Libertine-FPE/Open-airway/Alternative control board.pdf

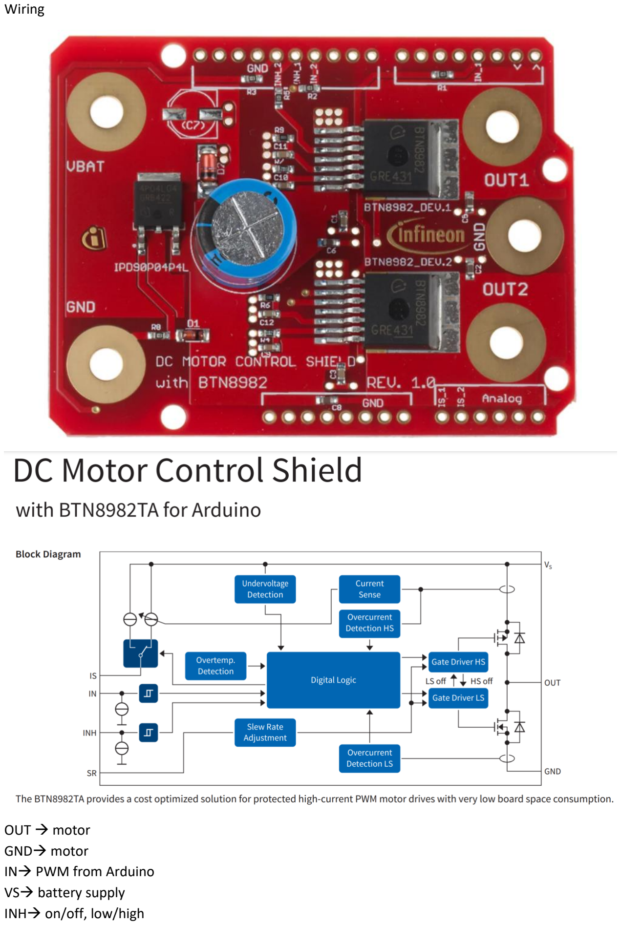
[picture p10: page 1]

Wiring

OUT → motor
GND→ motor
IN→ PWM from Arduino
VS→ battery supply
INH→ on/off, low/high

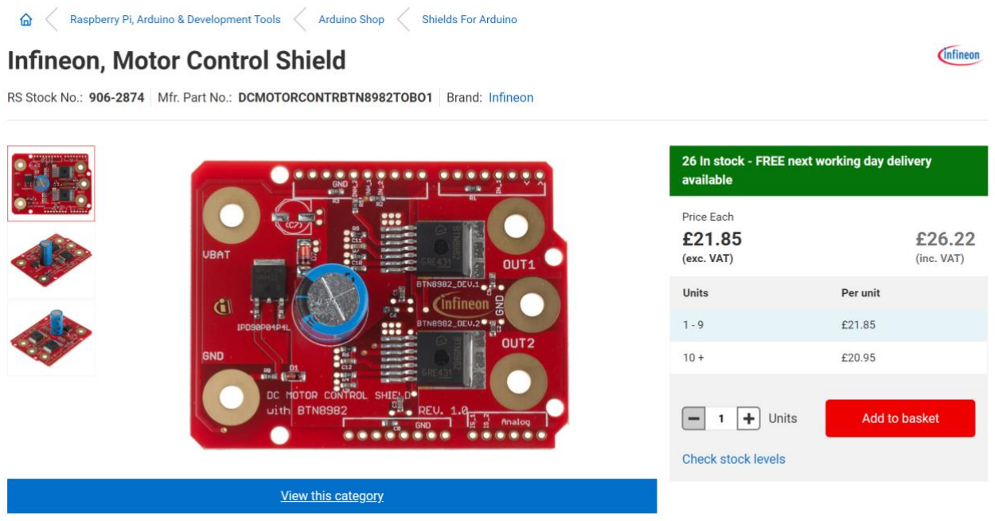
[picture p11: figure]

https://uk.rs-online.com/web/p/shields-for-arduino/9062874/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 (https://uk.rs-online.com/web/p/shields-for-arduino/9062874/?matchtype=&pla-341184811176&gclsrc=aw.ds)
