Libertine-FPE/Open-airway/BOM - Complete v2.xlsx

Open-airway.com Bag Valve Mask actuator |  |  |  |  |  |  | Version | 2 |  | Contact | Sam Cockerill
Bill of Materials |  |  |  |  |  |  | Date | 2020-04-16 |  | email | sam.cockerill@libertine.co.uk
Section | Short name | Component description | Vendor website | Vendor part number | Manufacturer | Mfr Part No | Quantity | Price per unit exc (£) | Min quantity | RoHS Compliant | Note
3D printed parts |  | BVA BASE LEFT v2 |  |  |  |  | 1 |  | 1 |  | PLA Filament
3D printed parts |  | BVA BASE RIGHT v2 |  |  |  |  | 1 |  | 1 |  | PLA Filament
3D printed parts |  | BVA BOTTOM STATOR SUPPORT v2 |  |  |  |  | 1 |  | 1 |  | PLA Filament
3D printed parts |  | BVA UPPER STATOR SUPPORT |  |  |  |  | 1 |  | 1 |  | PLA Filament
3D printed parts |  | BVA RISER v2 |  |  |  |  | 1 |  | 1 |  | PLA Filament
3D printed parts |  | BVA RISER SUPPORT |  |  |  |  | 1 |  | 1 |  | PLA Filament
3D printed parts |  | BVA MASK STRAP CLIP |  |  |  |  | 1 |  | 1 |  | PLA Filament
3D printed parts |  | BVA BAG PUSHER v2 |  |  |  |  | 2 |  | 2 |  | PLA Filament
3D printed parts |  | BVA CONTROL KNOB |  |  |  |  | 2 |  | 2 |  | PLA Filament
3D printed parts |  | BVA STATOR END CAP |  |  |  |  | 2 |  | 2 |  | ABS Filament
3D printed parts |  | BVA COIL BOBBIN |  |  |  |  | 2 |  | 2 |  | ABS Filament
3D printed parts |  | BVA END PLATE |  |  |  |  | 2 |  | 2 |  | ABS Filament
3D printed parts |  | BVA OUTER HOLDER |  |  |  |  | 2 |  | 2 |  | ABS Filament
3D printed parts |  | BVA ROD HOLDER |  |  |  |  | 2 |  | 2 |  | ABS Filament
Electrical machine |  | BVA BACK IRON |  |  |  |  | 2 |  | 2 |  | Manufacture to Drawing PDF
Electrical machine |  | BVA OUTER IRON |  |  |  |  | 2 |  | 2 |  | Manufacture to Drawing PDF
Electrical machine | Copper | 1.120mm Polyester C200 G2 D250 (~400turns/91m) | https://www.par.uk.com |  | P.A.R. Insulations & Wires Ltd |  | 2 | 6.15/kg | 20kg
Fixings | Threaded Insert | RS PRO, M6 Brass Threaded Insert diameter 8mm Depth 12.7mm | https://uk.rs-online.com/ | 278-578 | RS-PRO | 278-578 | 10 | 0.195 | 100
Fixings | Spring | RS PRO Steel Alloy Compression Spring, 80.5mm x 8.63mm, 0.17N/mm | https://uk.rs-online.com/ | 751-512 | RS-PRO | 751-512 | 5 | 0.71 | 5
Fixings | Bush | RS PRO Nylon Screw Insulator, M6, 8mm | https://uk.rs-online.com/ | 178-844 | RS-PRO | 178-844 | 2 | 0.08 | 50
Fixings | Studding | RS PRO Zinc Plated Steel Threaded Bar 0.242m | https://uk.rs-online.com/ | 530-321 | RS-PRO | 530-321 | 2 | 2.01 | 5
Fixings | M6x16 Screw | RS PRO M6 x 16mm Hex Socket Cap Screw Bright Zinc Plated Steel | https://uk.rs-online.com/ | 483-8326 | RS-PRO | 483-8326 | 4 | 0.144 | 100
Fixings | M6x30 Screw | RS PRO M6 x 30mm Hex Socket Cap Screw Bright Zinc Plated Steel | https://uk.rs-online.com/ | 483-8348 | RS-PRO | 483-8348 | 1 | 0.16 | 100
Fixings | 4mmx70 Screw | Pozidriv CSK Steel Wood Screw Yellow Passivated, Zinc Plated, 4mmx70mm | https://uk.rs-online.com/ | 145-6471 | UNIFIX VORTEX | ZZV60233CE | 5 | 0.031 | 200
Fixings | 3.5mmx30 Screw | Pozidriv CSK Wood Screw A2 3.5mm Thread 30mm Length | https://uk.rs-online.com/ | 144-3509 | RS-PRO | 144-3509 | 6 | 0.036 | 100
Fixings | No.6 Self Tap Screw | RS PRO BZP Steel Pan Head Self Tapping Screw, N°6 x 9.5mm Long | https://uk.rs-online.com/ | 546-5654 | RS-PRO | 546-5654 | 2 | 0.026 | 100
Fixings | M6 Washer | Bright Zinc Plated Steel Plain Washer, 1.5mm Thickness, M6 (Form C) | https://uk.rs-online.com/ | 122-4379 | RS-PRO | 122-4379 | 4 | 0.019 | 100
Fixings | Wago Connector | Wago 221 Terminal Block Connector, 2 Way/Pole, Spring Cage Terminals | https://uk.rs-online.com/ | 883-7544 | RS-PRO | 221-412 | 6 | 0.326 | 10
Fixings | P Clip | 9.5mm Black Polyamide P Clip | https://uk.rs-online.com/ | 474-543 | HellermannTyton | 211-60004 H5P-PA66HS-BK (100) | 2 | 0.072 | 100
Fixings | UNF Screw | 10-32 X 3/4 Inch UNF Cap Head Screws (ANSI B18.3) - A2 Stainless Steel | https://www.accu.co.uk | SSC-10-32-3/4-A2 | ACCU | SSC-10-32-3/4-A2 | 2 | 0.35 | 2
Electronics |  | Arduino Uno Rev3 MCU Development Board A000066 | https://uk.rs-online.com/ | 715-4081 | Arduino | A000066 | 1 | 16.44 | 1 | Yes
Electronics |  | MIKROE-512, 10 piece Breadboard Jumper Wire Kit | https://uk.rs-online.com/ | 791-6454 | MikroElektronika | MIKROE-512 | 1 | 2.41 | 1 | Yes
Electronics |  | MIKROE-511, 10 piece Breadboard Jumper Wire Kit | https://uk.rs-online.com/ | 791-6450 | MikroElektronika | MIKROE-511 | 1 | 2.41 | 1 | Yes
Electronics |  | RS PRO 10kΩ 0.25W Carbon Film Resistor ±5% | https://uk.rs-online.com/ | 707-7745 | RS PRO |  | 2 | 0.108 | 10 | Yes
Electronics |  | EA Elektro-Automatik Digital Bench Power Supply 320W, 1 Output 0 → 42V 20A | https://uk.rs-online.com/ | 756-8821 | EA Elektro-Automatik | EA-PS 2042-20B | 1 | 288.71 | 1 | Yes | Alternative cheap fixed supply 12V 20A PSU 161-8225 for £46.85
Electronics |  | VNH5019 Motor Driver Carrier 12A | https://www.pololu.com/product/1451 |  | VNH5019 | Pololu | 1 | 19.2 | 1 | Yes | Alternative 393-9377, or solid state relay with similar characteristics, 5V control, 20V@20A, with minimum of 500ms switch time
Electronics |  | CTS Linear Potentiometer with an 6.35 mm Dia. Shaft - 1kΩ, ±20%, 5W Power Rating, Linear, SMD | https://uk.rs-online.com/ | 179-0664 | CTS | 026TB32R102B1A1 | 2 | 2.58 | 1 | Yes
Electronics |  | Natural, White Round Tactile Switch, Single Pole Single Throw (SPST) 50 mA 2.5 (Dia.)mm PCB | https://uk.rs-online.com/ | 909-7993 | TE Connectivity | 1571634-2 | 4 | 0.133 | 10 | Yes
Electronics |  | Alpha Wire Black, 3.3 mm² Hook Up Wire EcoWire Series , 30m | https://uk.rs-online.com/ | 687-7639 | Alpha Wire | 6718 BK005 | 1 | 42.84 | 1 | Yes
Electronics |  | Alpha Wire Red, 3.3 mm² Hook Up Wire EcoWire Series , 30m | https://uk.rs-online.com/ | 687-7648 | Alpha Wire | 6718 RD005 | 1 | 42.84 | 1 | Yes
Electronics |  | 2.2 V Green LED 3mm Through Hole, Kingbright L-934GD | https://uk.rs-online.com/ | 228-5944 | Kingbright | L-934GD | 2 | 0.4 | 5 | Yes
Electronics |  | 2 V Red LED 3mm Through Hole, Kingbright L-934ID | https://uk.rs-online.com/ | 228-5916 | Kingbright | L-934ID | 2 | 0.4 | 5 | Yes
Electronics |  | Marquardt Single Pole Single Throw (SPST), On-None-Off Rocker Switch Panel Mount | https://uk.rs-online.com/ | 741-0902 | Marquardt | 1831.3313 | 1 | 2.33 | 1 | Yes
Electronics |  | RS PRO Single Pole Single Throw (SPST) Latching Push Button Switch, 4.95 (Dia.)mm, Panel Mount, 32/50/12 | https://uk.rs-online.com/ | 734-6750 | RS PRO |  | 1 | 3.3 | 1 | Yes
Electronics |  | Littelfuse 20A Inline Fuse Holder for ATO Blade Fuse, 32V ac/dc | https://uk.rs-online.com/ | 787-4356 | Littelfuse | FHAC0001ZXJG | 4 | 3.25 | 1 | Yes
Electronics |  | RS PRO 20A Yellow Car Fuse, 32V dc | https://uk.rs-online.com/ | 563-762 | RS PRO |  | 2 | 141 | 10 | Yes
Electronics |  | Littelfuse 1A Black Car Fuse, 32V dc | https://uk.rs-online.com/ | 787-4110 | Littelfuse | 0287001.PXCN | 2 | 0.172 | 10 | Yes
Electronics |  | RS PRO Battery Terminal, Screw | https://uk.rs-online.com/ | 509-7633 | RS PRO |  | 2 | 6.97 | 1 | Yes
Electronics |  | Displaytech 204A-CC-BC-3LP Alphanumeric LCD Display, White on Blue, 4 Rows by 20 Characters, Transflective | https://uk.rs-online.com/ | 532-6818 | Displaytech | 204A-CC-BC-3LP | 1 | 11.35 | 1 | Yes
Flow Parts |  | Key Instruments Variable Area Flow Meter, 2 L/min → 30 L/min, MR3000 Series | https://uk.rs-online.com/ | 448-7445 | Key Instruments | MR3A16BVBN | 1 | 67.72 | 1
Flow Parts |  | Legris Threaded-to-Tube Pneumatic Fitting NPT 1/8 to Push In 6 mm, LF3800 Series, 20 bar | https://uk.rs-online.com/ | 536-2577 | Legris | 3805 06 11 | 2 | 9.82 | 2
