Libertine-FPE/Open-airway/BVA COIL BOBBIN.stl

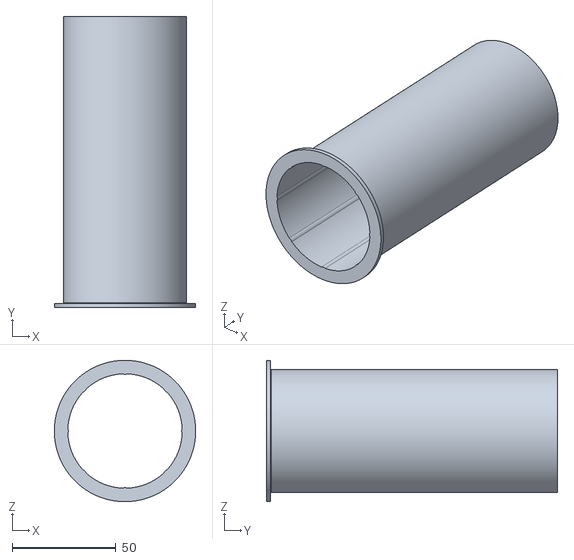
[picture p12: CAD file, 2020-04-16]
BVA COIL BOBBIN.stl
68.0 x 140.0 x 68.0
