Libertine-FPE/Open-airway/BVA END PLATE.stl

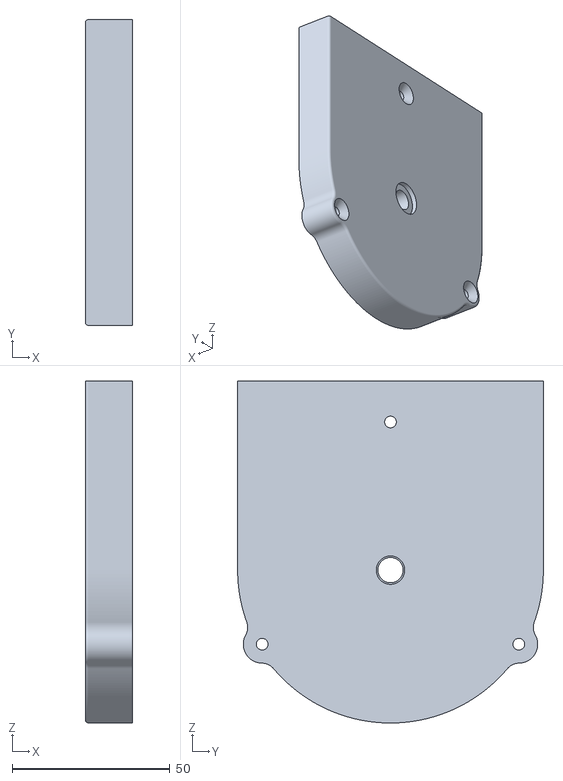
[picture p13: CAD file, 2020-04-16]
BVA END PLATE.stl
15.0 x 97.0 x 108.5
