Libertine-FPE/Open-airway/BVA RISER v2.stl

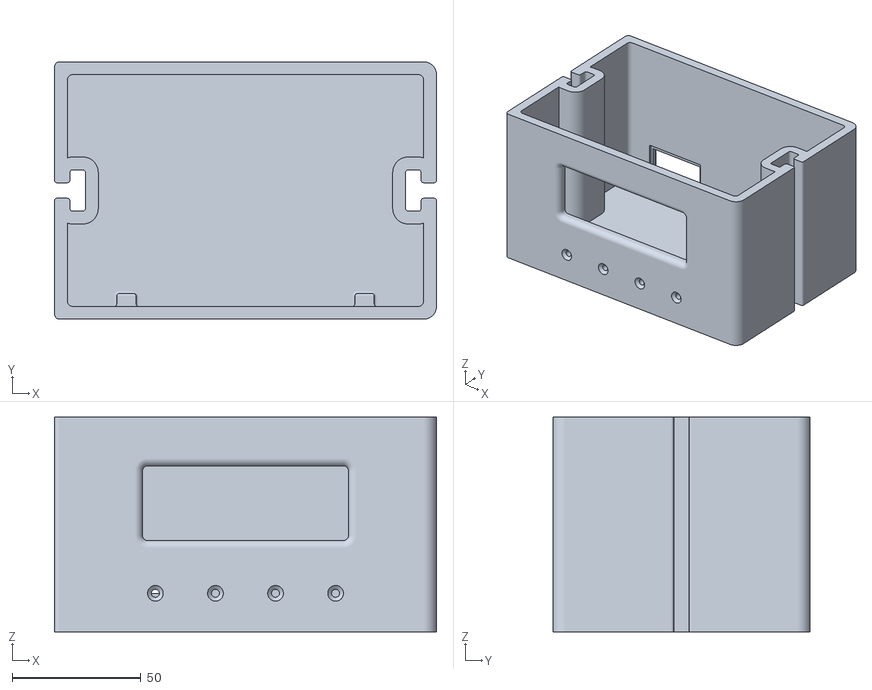
[picture p14: CAD file, 2020-04-16]
BVA RISER v2.stl
148.4 x 100.0 x 83.4
