Libertine-FPE/Open-airway/BVA BAG PUSHER v2.stl

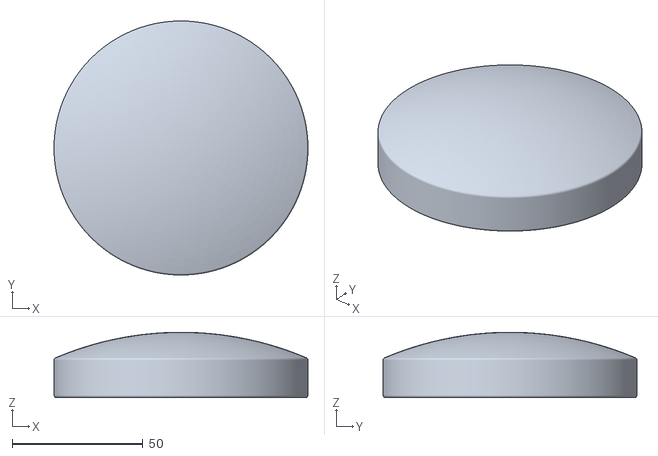
[picture p15: CAD file, 2020-04-16]
BVA BAG PUSHER v2.stl
97.0 x 97.0 x 25.0
