Libertine-FPE/Open-airway/BVA STATOR END CAP.stl

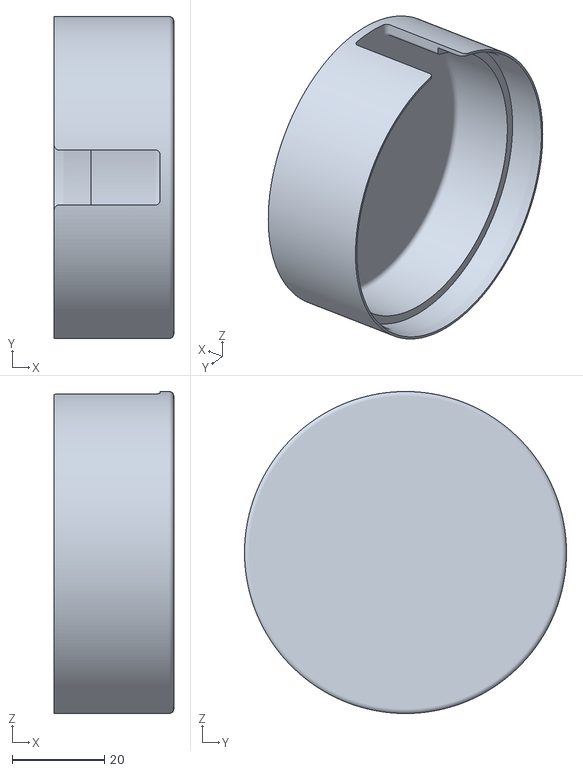
[picture p16: CAD file, 2020-04-16]
BVA STATOR END CAP.stl
26.0 x 70.0 x 70.0
