Libertine-FPE/Open-airway/BVA CONTROL KNOB.stl

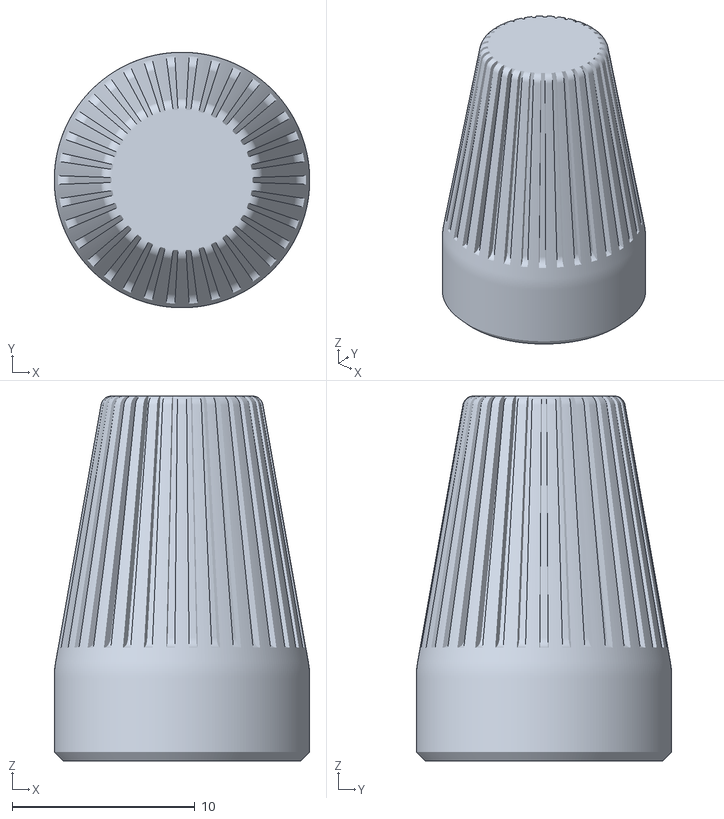
[picture p17: CAD file, 2020-04-16]
BVA CONTROL KNOB.stl
14.0 x 14.0 x 20.0
